alexisvl/mini-audioscope/datasheets/6LO1I-English.png

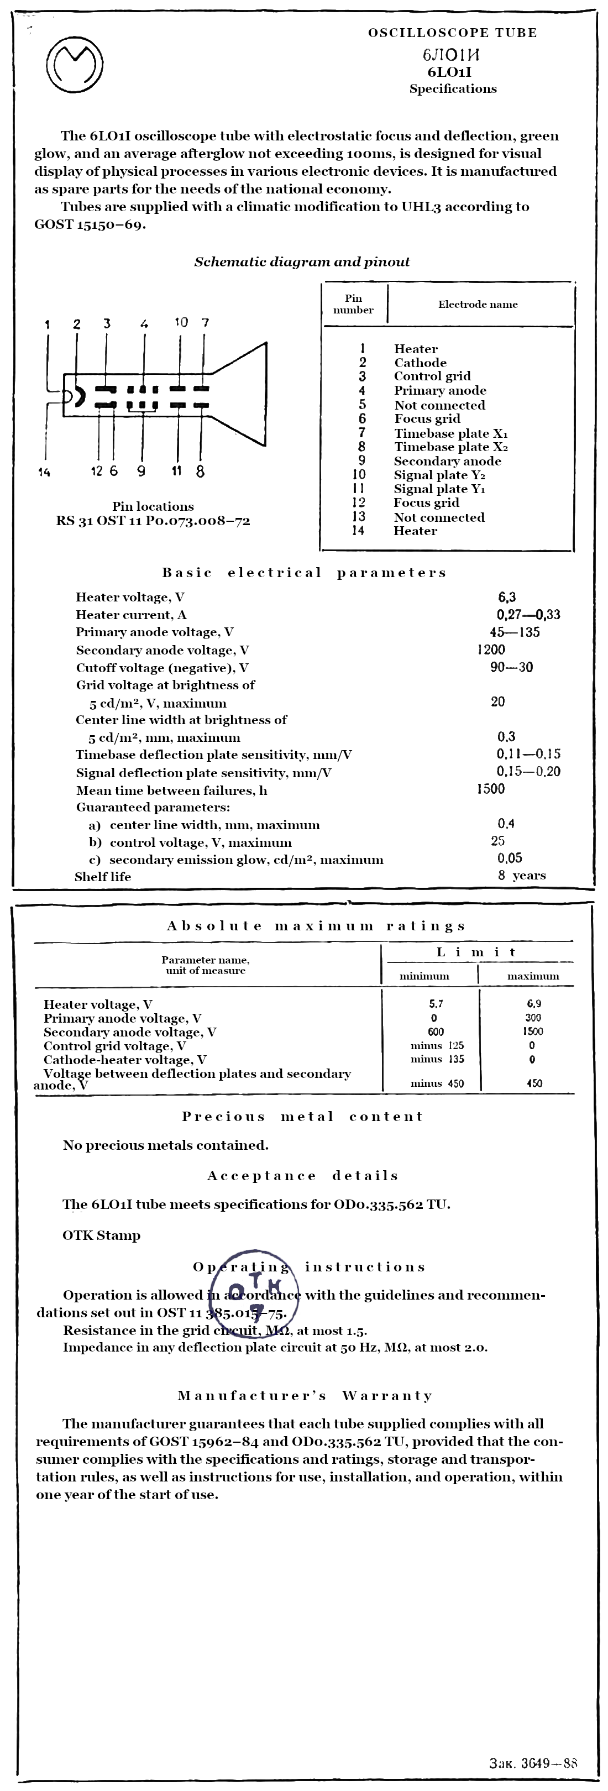
datasheets/6LO1I-English.png
