alexisvl/mini-audioscope/datasheets/6LO1I-Russian.png

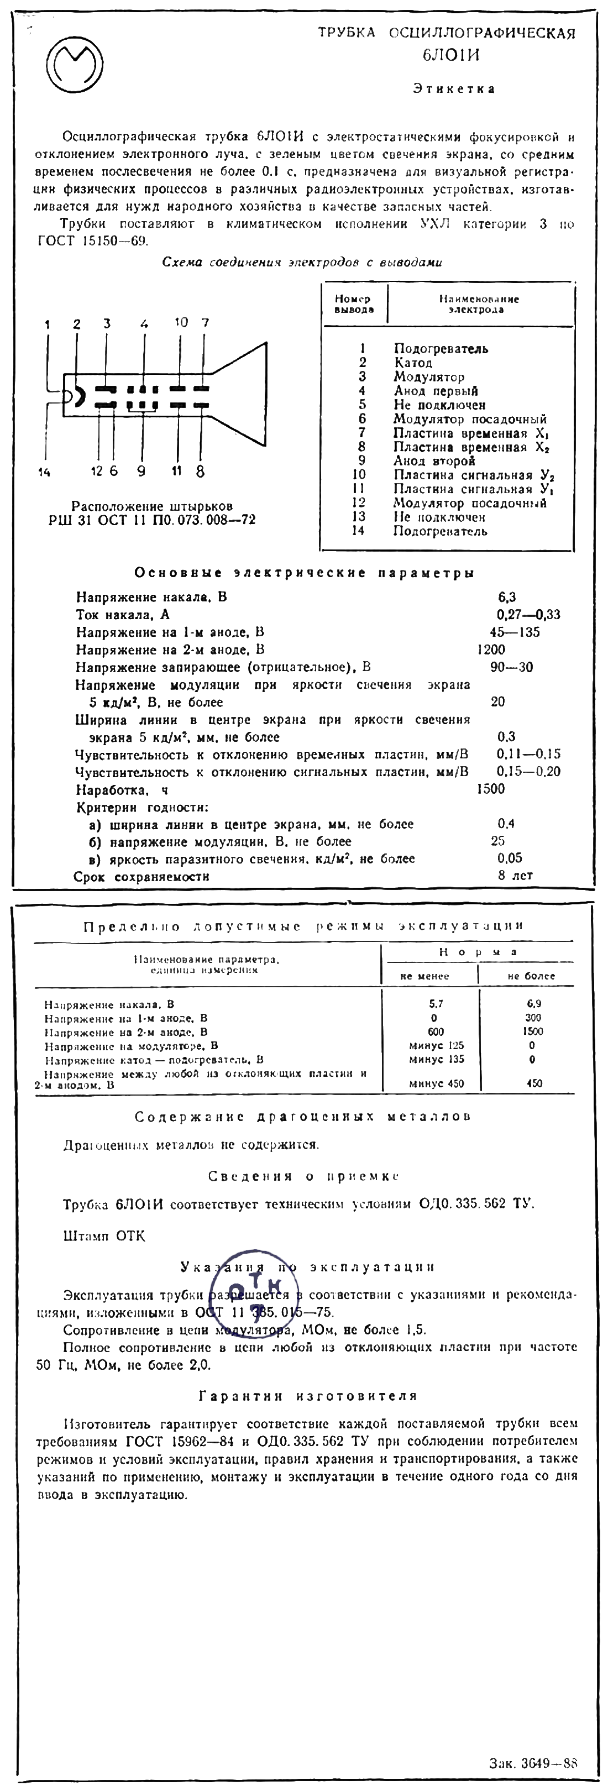
datasheets/6LO1I-Russian.png
