alexisvl/mini-audioscope/wiring-diagram.pdf

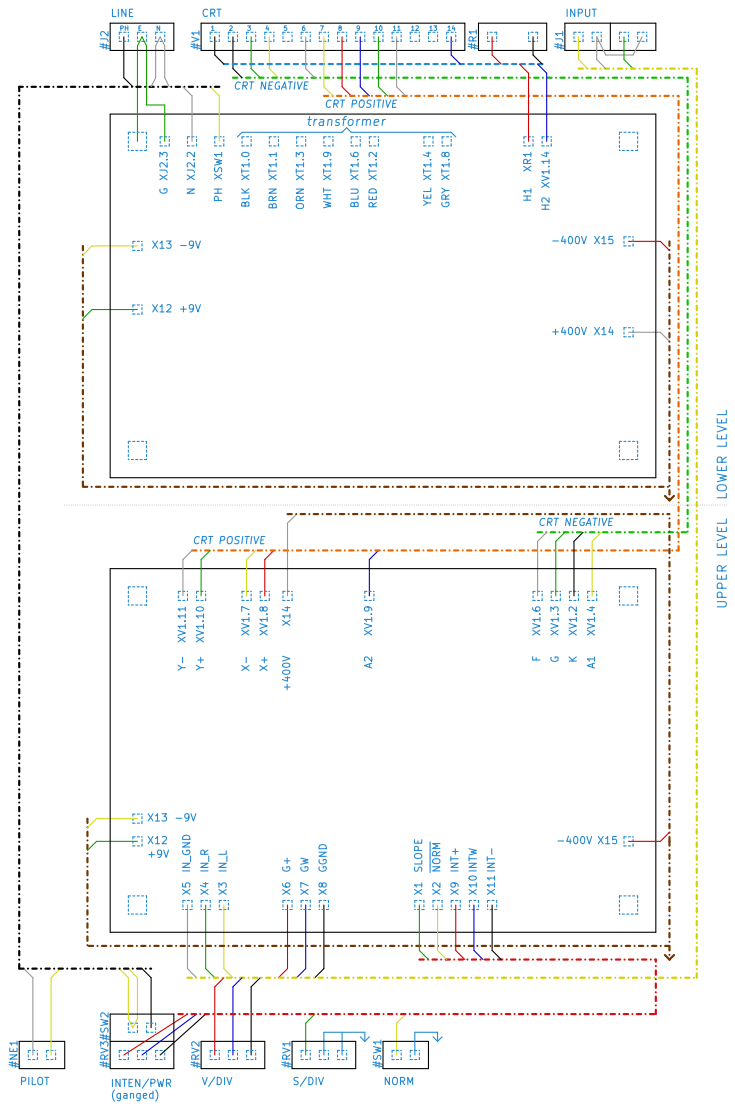
[picture p3: page 1]

File: wiring-diagram.sch Sheet: / Alexis Lockwood CC BY-SA-NC

Id: 1/1 Title: Mini Audioscope Wiring
