alexisvl/mini-audioscope/mini-audioscope.pdf

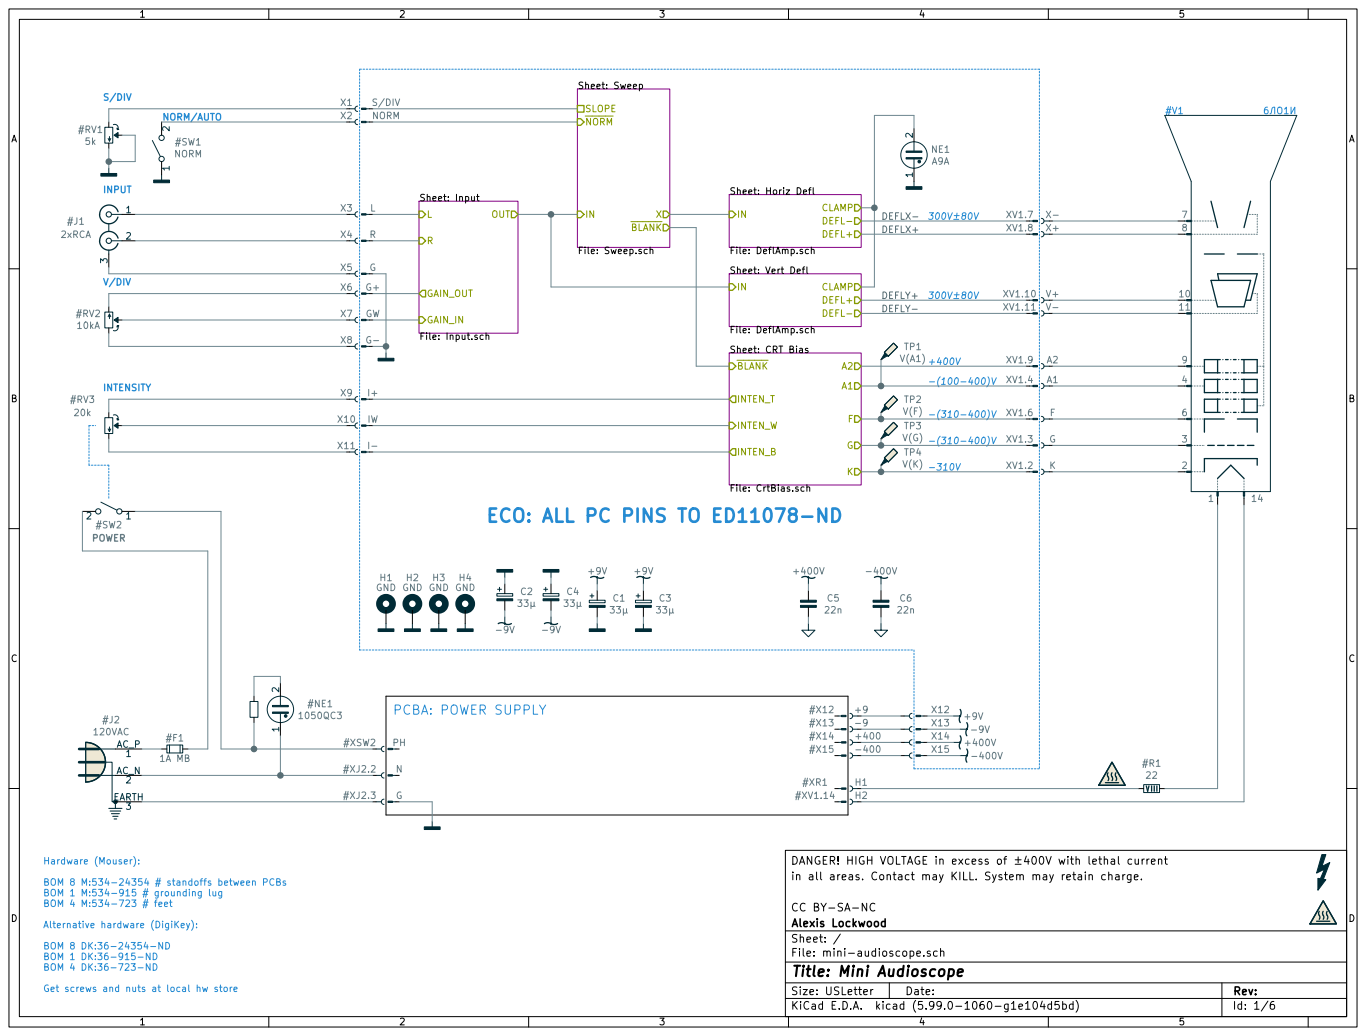
[picture p4: page 1]

BLANK
Sheet: CRT Bias File: CrtBias.sch BLANK

Hardware (Mouser): BOM 8 M:534-24354 # standoffs between PCBs BOM 1 M:534-915 # grounding lug BOM 4 M:534-723 # feet Alternative hardware (DigiKey): BOM 8 DK:36-24354-ND

in all areas. Contact may KILL. System may retain charge. DANGER! HIGH VOLTAGE in excess of ±400V with lethal current

File: mini-audioscope.sch Sheet: / Alexis Lockwood CC BY-SA-NC

Id: 1/6 Title: Mini Audioscope

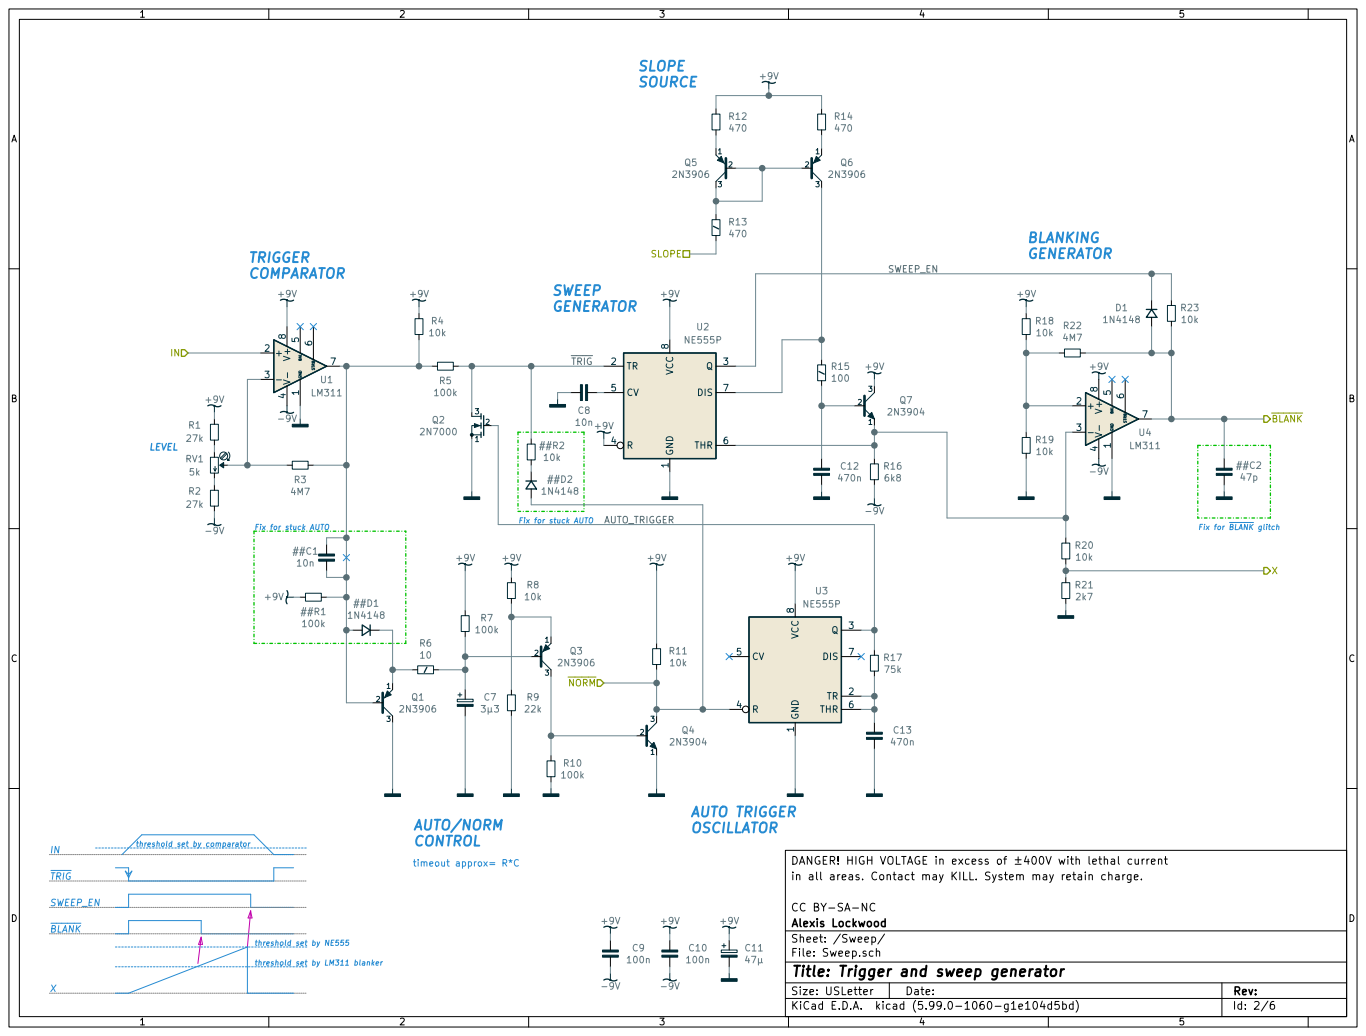
[picture p5: page 2]

Fix for BLANK glitch SWEEP
GENERATOR

in all areas. Contact may KILL. System may retain charge. DANGER! HIGH VOLTAGE in excess of ±400V with lethal current C8
BLANK NORM

Fix for stuck AUTO

threshold set by comparator IN

Sheet: /Sweep/ Alexis Lockwood CC BY-SA-NC

File: Sweep.sch
Id: 2/6 Title: Trigger and sweep generator

threshold set by LM311 blanker

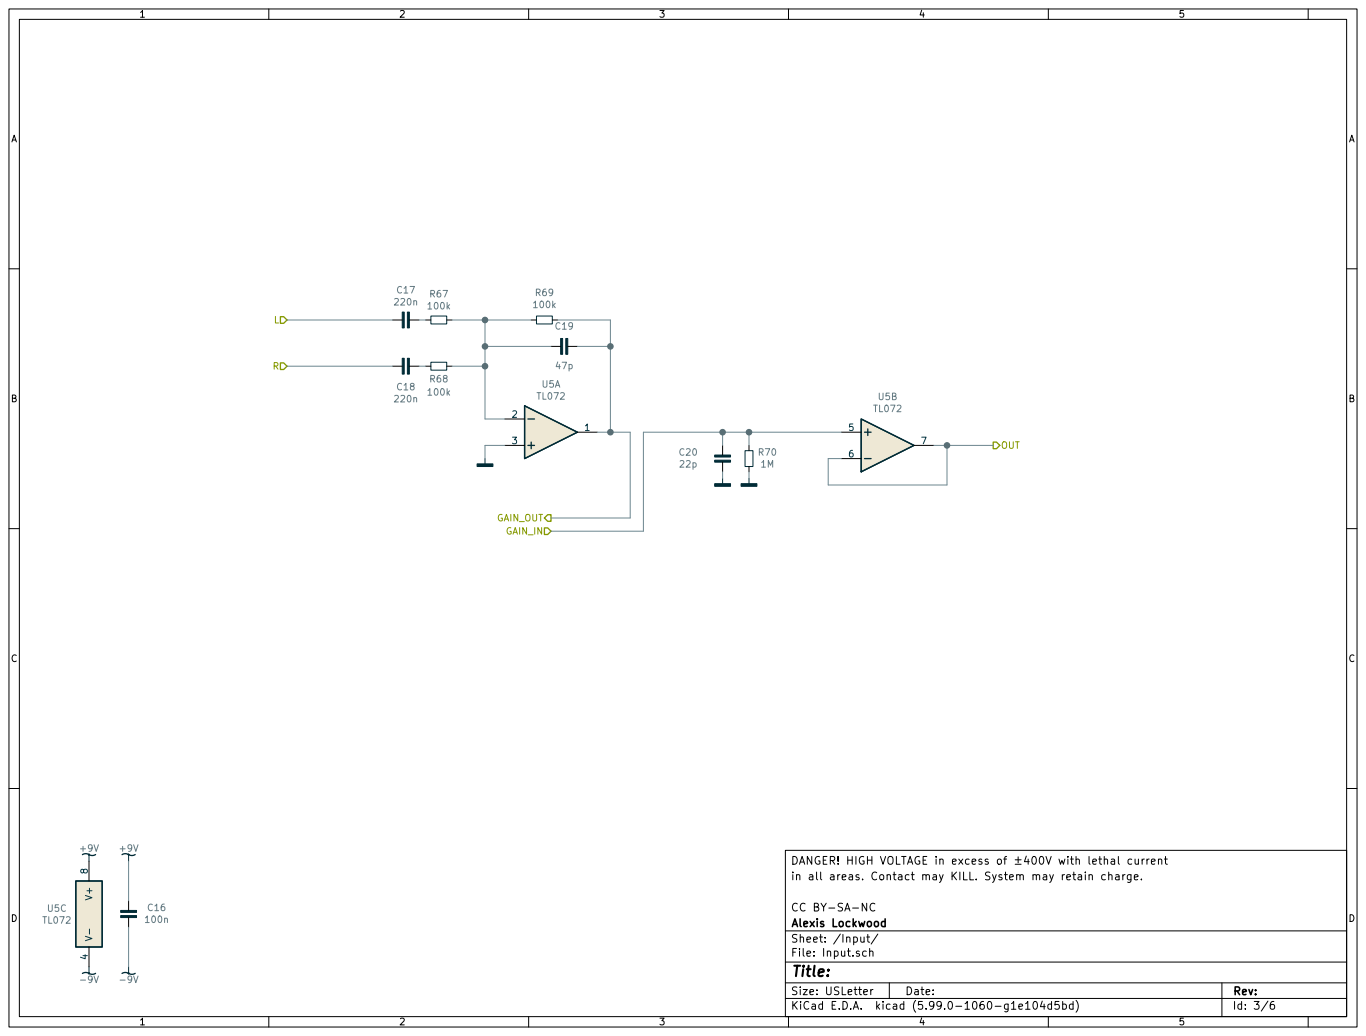
[picture p6: page 3]

in all areas. Contact may KILL. System may retain charge. DANGER! HIGH VOLTAGE in excess of ±400V with lethal current -9V

Sheet: /Input/ Alexis Lockwood CC BY-SA-NC

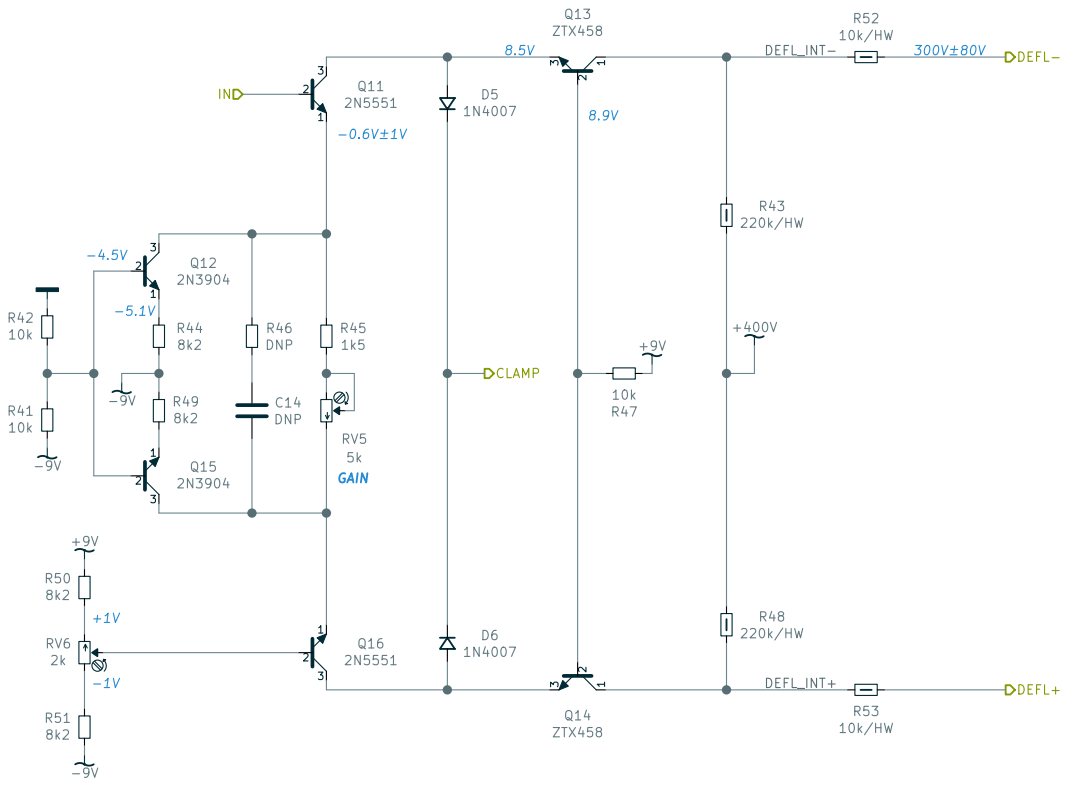
[picture p7: page 4]

in all areas. Contact may KILL. System may retain charge. DANGER! HIGH VOLTAGE in excess of ±400V with lethal current 1

File: DeflAmp.sch Sheet: /Horiz Defl/ Alexis Lockwood CC BY-SA-NC

Id: 4/6 Title: Deflection Amplifier

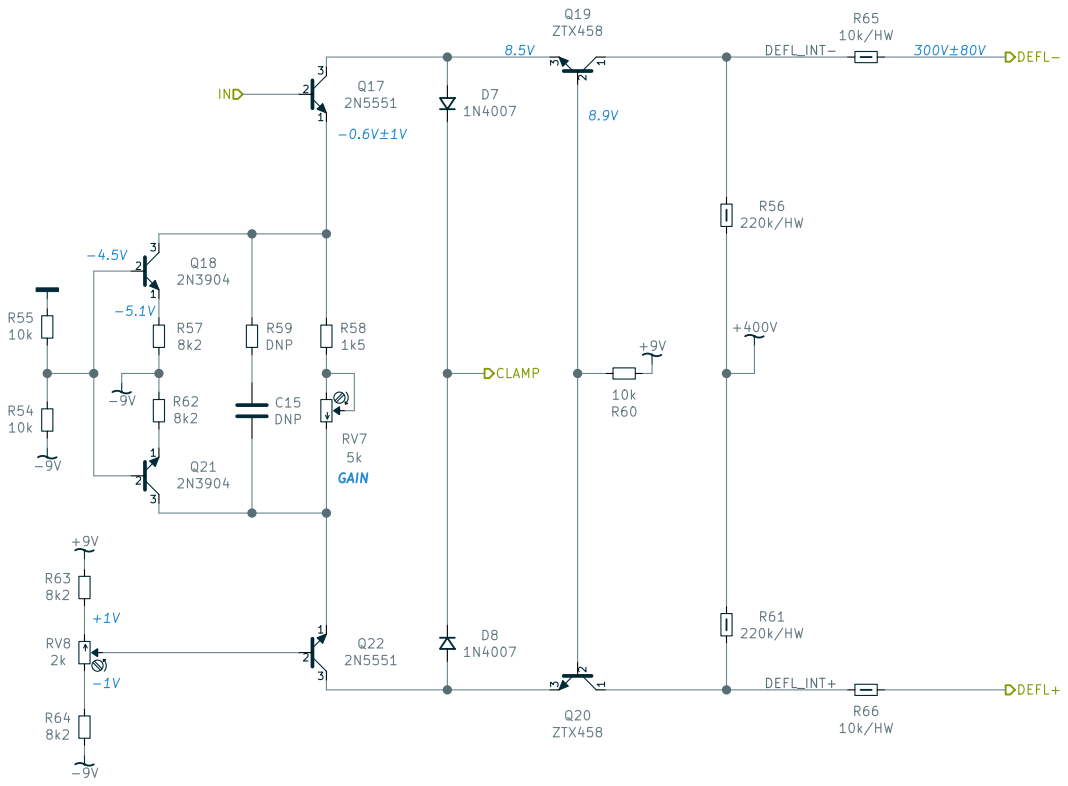
[picture p8: page 5]

in all areas. Contact may KILL. System may retain charge. DANGER! HIGH VOLTAGE in excess of ±400V with lethal current R63

File: DeflAmp.sch Sheet: /Vert Defl/ Alexis Lockwood CC BY-SA-NC

Id: 5/6 Title: Deflection Amplifier

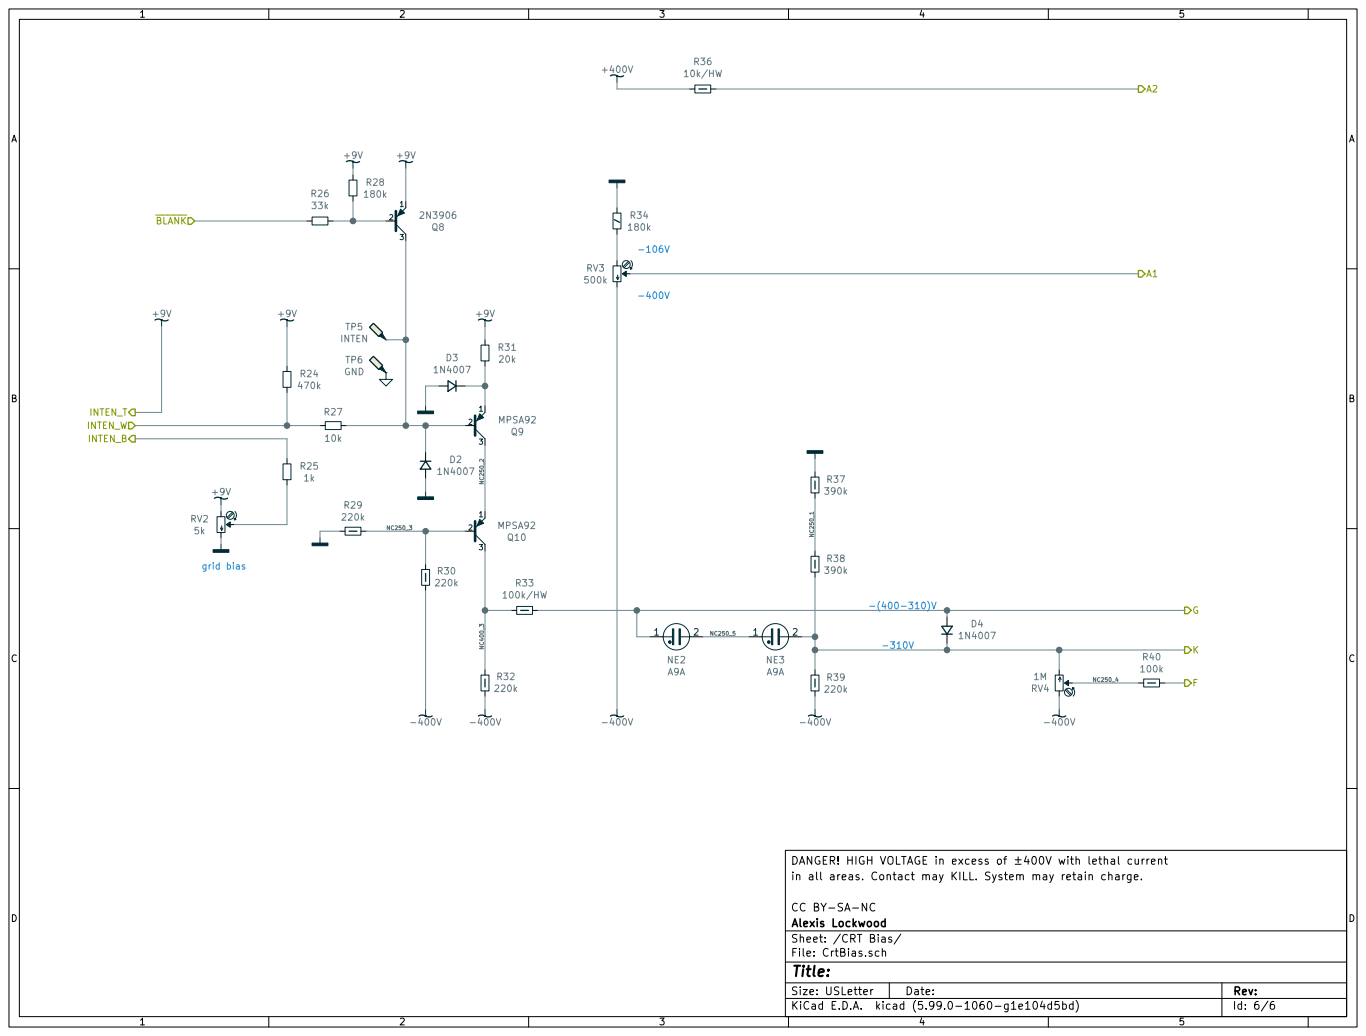
[picture p9: page 6]
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

Id: 6/6 Title: File: CrtBias.sch Sheet: /CRT Bias/ Alexis Lockwood CC BY-SA-NC
