alexisvl/mini-audioscope/pcb-power/pcb-power.pdf

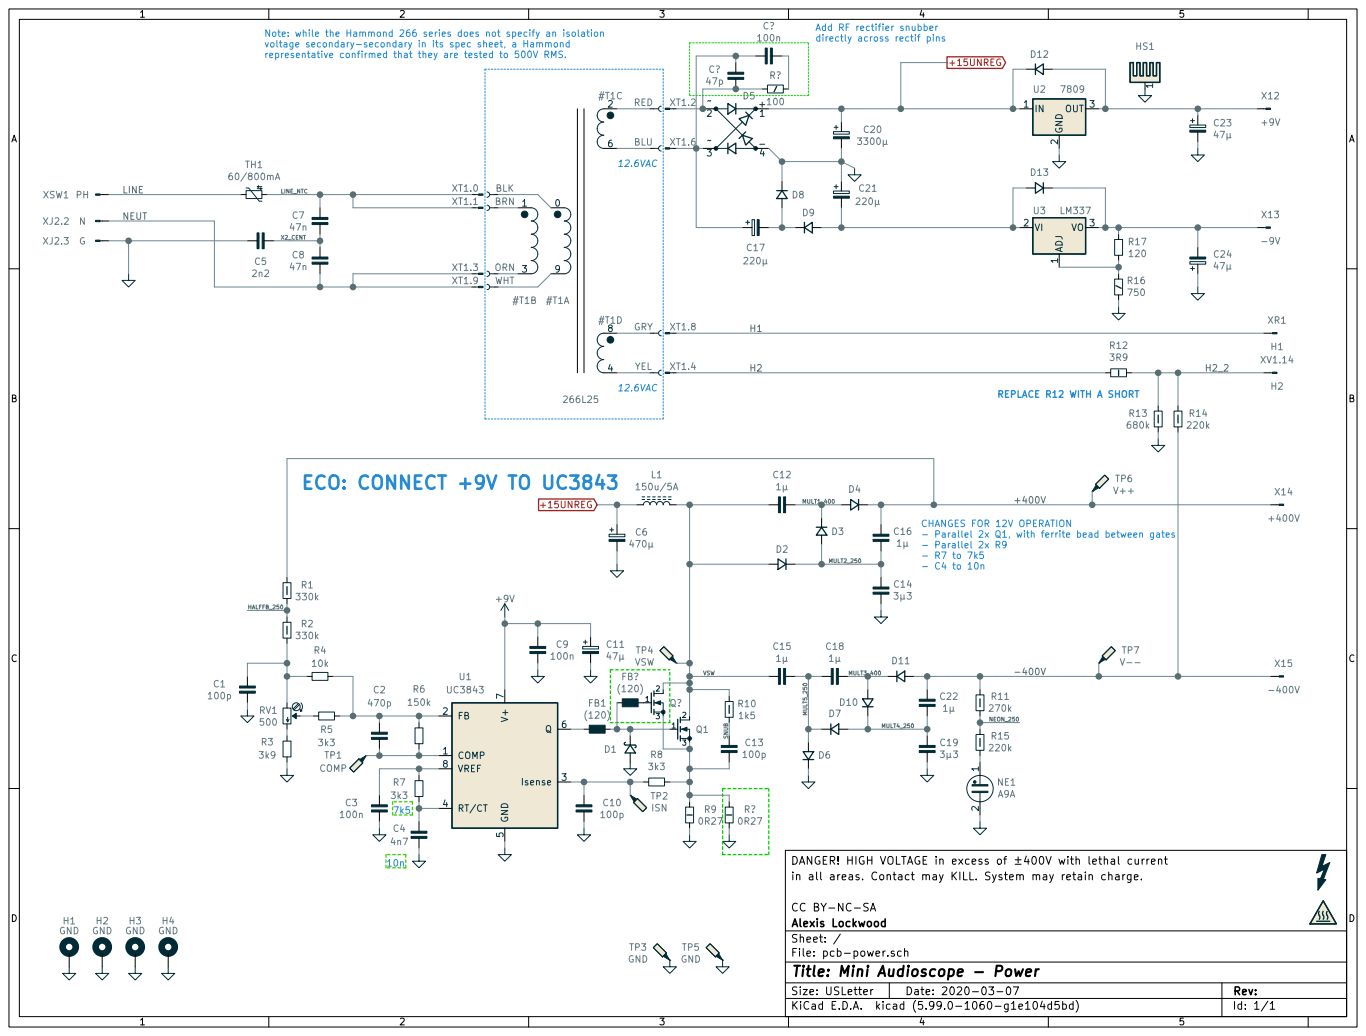
[picture p10: page 1]

Add RF rectifier snubber directly across rectif pins 12.6VAC

Note: while the Hammond 266 series does not specify an isolation
voltage secondary-secondary in its spec sheet, a Hammond

CHANGES FOR 12V OPERATION
- Parallel 2x Q1, with ferrite bead between gates
- Parallel 2x R9

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

File: pcb-power.sch Sheet: / Alexis Lockwood CC BY-NC-SA

Id: 1/1 Title: Mini Audioscope - Power
