alexisvl/mini-audioscope/spice/horiz.asc

C1: cap; 470n
C2: cap; 3µ3
C3: cap; 470n
C4: cap; 10n
C5: cap; 47p
D1: diode
D2: diode
D4: diode; 1N4148
M1: nmos; 2N7002
Q1: pnpr; 2N3906
Q2: npn; 2N3904
Q3: pnpr; 2N3906
Q4: pnpr; 2N3906
Q6: npn; 2N3904
R1: res; 6k8
R2: res; 3k3
R3: res; 1k
R4: res; 100k
R5: res; 10k
R6: res; 10k
R7: res; 4.7Meg
R8: res; 10k
R9: res; 20k
R10: res; 20k
R11: res; 4.7Meg
R12: res; 10k
R13: res; 10
R14: res; 100
R15: res; 75k
R16: res; 100k
R17: res; 10k
R18: res; 100k
R19: res; 100k
R20: res; 10k
R21: res; 2k7
R22: res; 100k
R23: res; 22k
R24: res; 10k
R25: res; 10k
U1: NE555
U2: LMx11
U4: NE555
U6: LMx11
V1: voltage; SINE(0 1 100 0.4 0 0 6.75)
V2: voltage; PULSE(0 1 467.06m)
V3: voltage; 9
V4: voltage; -9
Named nets: 0, V+, V-, sweep_en, x, _blank
.lib bipolar.lib
.tran 2 startup
