alexisvl/mini-audioscope/spice/power-uc3842.asc

C1: cap; 470p
C2: cap; 10n
C3: cap; 3µ3; Rser=0.15
C4: cap; 1µ; Rser=0.2
C5: cap; 1µ; Rser=0.2
C6: cap; 100p
C7: cap; 1µ; Rser=0.2
C8: cap; {5*22n}; Rser=0.2
C9: cap; 3µ3; Rser=0.15
C10: cap; 1µ; Rser=0.2
C11: cap; 100p
C12: cap; 100p
C13: cap; 100n
C15: cap; 470µ; Rser=.05
D2: diode; UF4007
D3: diode; UF4007
D4: diode; UF4007
D5: diode; UF4007
D6: diode; UF4007
D7: diode; UF4007
D8: diode; UF4007
D10: schottky; MBR0530L
L1: ind; 150µ; Rser=0.071
L2: FerriteBead; 377n; Ipk=3 Rser=0.027 Rpar=177 Cpar=847f mfg="Würth Elektronik" pn="742792023 WE-CBF 0805"
L3: FerriteBead; 377n; Ipk=3 Rser=0.027 Rpar=177 Cpar=847f mfg="Würth Elektronik" pn="742792023 WE-CBF 0805"
R2: res; 10k
R3: res; 1k5
R4: res; {0.27/2}
R5: res; 150k
R6: res; 7k5
R7: res; 330k
R8: res; 3k9
R9: res; 390k
R10: res; 3k3
R11: res; 80k
R12: res; 3k3
R13: res; 330k
U1: nmos-subckt; IPS70R1K4CE_L0
U2: neonbulb; Vstrike=90 Vhold=65
U3: pot; Rt=500 set=.5
U4: nmos-subckt; IPS70R1K4CE_L0
U5: LT1243
V1: voltage; 12; Rser=0.1
V2: voltage; 30; Rser=.01
V3: voltage; 9
Named nets: V+, +25, 0
.lib diode.lib
.tran 1 uic startup
.lib SimulationModel_PowerMOSFET_PSpice_700V_CoolMOS_CE.LIB
(IPN70R1K5CEATMA1)
