alexisvl/mini-audioscope/spice/deflection.asc

C1: cap; 47p
Q1: npn; MPSA44
Q2: npn; MPSA44
Q3: npn; 2N5551
Q4: npn; 2N5551
Q5: npn; 2N3904
Q6: npn; 2N3904
R1: res; 10k
R2: res; 470
R3: res; 470
R4: res; 1k5
R5: res; 5k
R6: res; 10k
R7: res; 10k
R8: res; 8k2
R9: res; 8k2
R10: res; 220k
R11: res; 220k
V1: voltage; 400
V2: voltage; 9
V3: voltage; -9
V4: voltage; SINE(0 1 10k); AC 1
Named nets: 0, +400, +9, -9
.lib bipolar.lib
.tran 10m
275 midpt
375 peak
;ac dec 50 10 500k
