alexisvl/mini-audioscope/spice/power.asc

C1: cap; 100p
C2: cap; 680p
C3: cap; 3µ3; Rser=2
C4: cap; 1µ; Rser=3
C5: cap; 1µ; Rser=3
C6: cap; 10n
C7: cap; 1µ; Rser=3
C8: cap; 1µ; Rser=3
C9: cap; 1µ; Rser=3
C10: cap; 1µ; Rser=3
C11: cap; 100p
D2: diode; UF4007
D3: diode; UF4007
D4: diode; UF4007
D5: diode; UF4007
D6: diode; UF4007
D7: diode; UF4007
D8: diode; UF4007
L1: ind; 150µ; Rser=0.01
M1: nmos; R6020PNJ
Q1: pnpr; 2N3906
Q2: npn; 2N3904
Q3: pnpr; 2N3906
Q4: npn; 2N3904
R1: res; 100
R2: res; 2.2
R3: res; 4k7
R4: res; 0.33
R5: res; 100
R6: res; 1k
R7: res; 470k
R8: res; 1k6
R9: res; 200k
R10: res; 4k7
R11: res; 330
U1: MC34063
U2: neonbulb
V1: voltage; 25; Rser=0.1
V2: voltage; 30; Rser=.01
V3: voltage; 15
Named nets: 0, V+, +25
.lib diode.lib
.tran 1 uic
