alexisvl/mini-audioscope/mini-audioscope.kicad_pcb

## KiCad design mini-audioscope.kicad_pcb (2020-03-29)

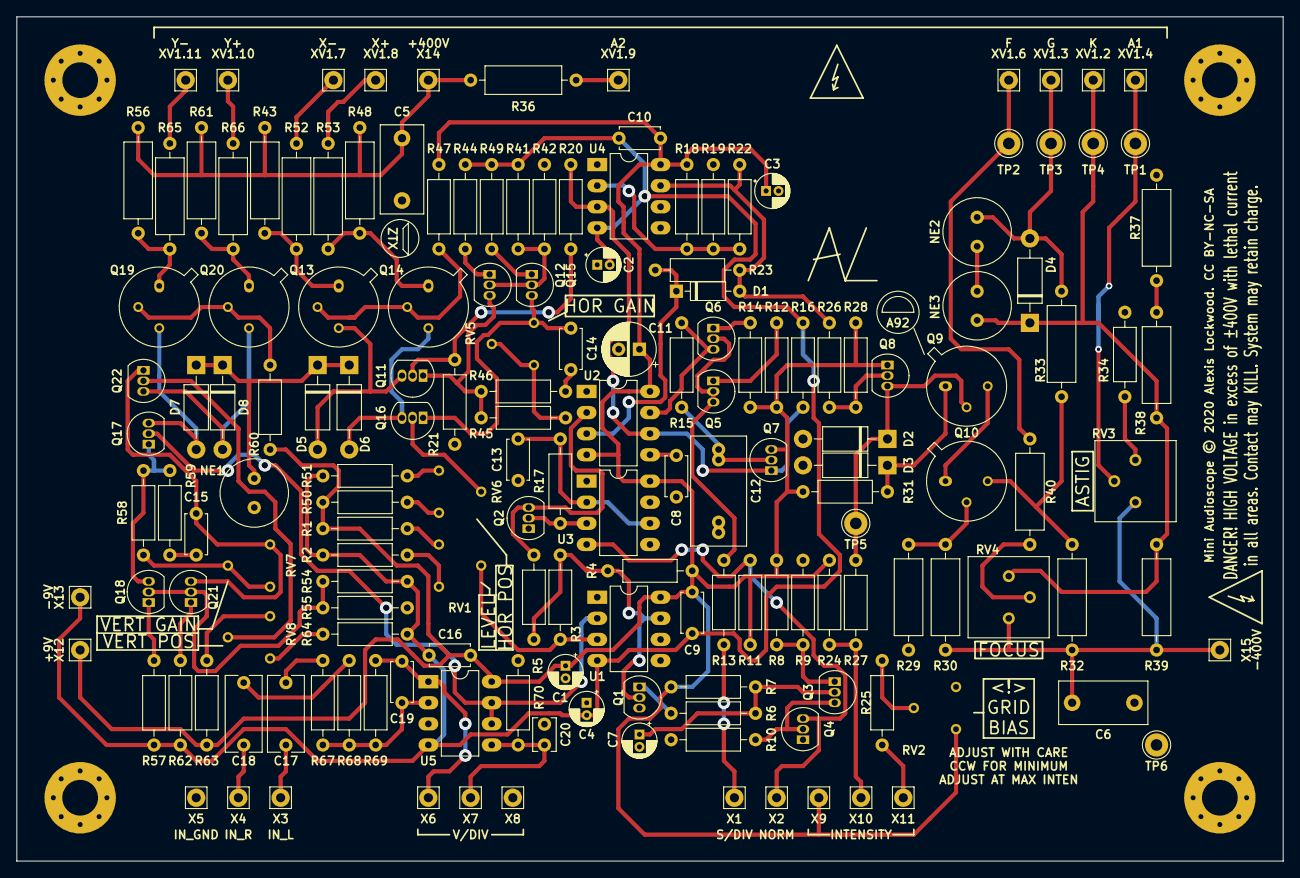
[picture p11: board mini-audioscope.kicad_pcb from above]

Board: 2 copper layers, 152.4 x 101.6 mm, 169 parts (0 on the bottom side), 90 nets.

Parts:
C1, C2, C3, C4: 33µ; CP_Radial_D4.0mm_P1.50mm
C5, C6: 22n; C_Disc_D10.5mm_W5.0mm_P7.50mm
C7: 3µ3; CP_Radial_D4.0mm_P1.50mm
C8: 10n; C_Disc_D4.7mm_W2.5mm_P5.00mm
C9, C10, C16: 100n; C_Disc_D4.7mm_W2.5mm_P5.00mm
C11: 47µ; CP_Radial_D6.3mm_P2.50mm
C12: 470n; C_Rect_L13.0mm_W6.5mm_P7.50mm_P10.00mm
C13: 470n; C_Disc_D4.7mm_W2.5mm_P5.00mm
C14, C15: DNP; C_Disc_D4.7mm_W2.5mm_P5.00mm
C17, C18: 220n; C_Rect_L9.0mm_W4.2mm_P7.50mm_MKT
C19: 47p; C_Disc_D4.7mm_W2.5mm_P5.00mm
C20: 22p; C_Disc_D3.8mm_W2.6mm_P2.50mm
D1: 1N4148; D_DO-35_SOD27_P7.62mm_Horizontal
D2, D3, D4, D5, D6, D7, D8: 1N4007; D_DO-41_SOD81_P10.16mm_Horizontal
H1, H2, H3, H4: GND; MountingHole_4.3mm_M4_Pad_Via
NE1, NE2, NE3: A9A; C_Radial_D8.0mm_H11.5mm_P3.50mm
Q1, Q3, Q5, Q6, Q8: 2N3906; TO-92_Inline
Q2: 2N7000; TO-92_Inline
Q4, Q7, Q12, Q15, Q18, Q21: 2N3904; TO-92_Inline
Q9, Q10: MPSA92; TO-5-3
Q11, Q16, Q17, Q22: 2N5551; TO-92_Inline
Q13, Q14, Q19, Q20: ZTX458; TO-5-3
R1, R2: 27k; R_Axial_DIN0207_L6.3mm_D2.5mm_P10.16mm_Horizontal
R3, R22: 4M7; R_Axial_DIN0207_L6.3mm_D2.5mm_P10.16mm_Horizontal
R4, R8, R11, R18, R19, R20, R23, R27, R41, R42, R47, R54, R55, R60: 10k; R_Axial_DIN0207_L6.3mm_D2.5mm_P10.16mm_Horizontal
R5, R7, R10, R67, R68, R69: 100k; R_Axial_DIN0207_L6.3mm_D2.5mm_P10.16mm_Horizontal
R6: 10; R_Axial_DIN0207_L6.3mm_D2.5mm_P10.16mm_Horizontal
R9: 22k; R_Axial_DIN0207_L6.3mm_D2.5mm_P10.16mm_Horizontal
R12, R13, R14: 470; R_Axial_DIN0207_L6.3mm_D2.5mm_P10.16mm_Horizontal
R15: 100; R_Axial_DIN0207_L6.3mm_D2.5mm_P10.16mm_Horizontal
R16: 6k8; R_Axial_DIN0207_L6.3mm_D2.5mm_P10.16mm_Horizontal
R17: 75k; R_Axial_DIN0207_L6.3mm_D2.5mm_P10.16mm_Horizontal
R21: 2k7; R_Axial_DIN0207_L6.3mm_D2.5mm_P10.16mm_Horizontal
R24: 470k; R_Axial_DIN0207_L6.3mm_D2.5mm_P10.16mm_Horizontal
R25: 1k; R_Axial_DIN0207_L6.3mm_D2.5mm_P10.16mm_Horizontal
R26: 33k; R_Axial_DIN0207_L6.3mm_D2.5mm_P10.16mm_Horizontal
R28, R34: 180k; R_Axial_DIN0207_L6.3mm_D2.5mm_P10.16mm_Horizontal
R29, R30, R32, R39, R43, R48, R56, R61: 220k/HW; R_Axial_DIN0309_L9.0mm_D3.2mm_P12.70mm_Horizontal
R31: 20k; R_Axial_DIN0207_L6.3mm_D2.5mm_P10.16mm_Horizontal
R33, R40: 100k/HW; R_Axial_DIN0309_L9.0mm_D3.2mm_P12.70mm_Horizontal
R36, R52, R53, R65, R66: 10k/HW; R_Axial_DIN0309_L9.0mm_D3.2mm_P12.70mm_Horizontal
R37, R38: 390k/HW; R_Axial_DIN0309_L9.0mm_D3.2mm_P12.70mm_Horizontal
R44, R49, R50, R51, R57, R62, R63, R64: 8k2; R_Axial_DIN0207_L6.3mm_D2.5mm_P10.16mm_Horizontal
R45, R58: 1k5; R_Axial_DIN0207_L6.3mm_D2.5mm_P10.16mm_Horizontal
R46, R59: DNP; R_Axial_DIN0207_L6.3mm_D2.5mm_P10.16mm_Horizontal
R70: 1M; R_Axial_DIN0207_L6.3mm_D2.5mm_P10.16mm_Horizontal
RV1, RV2, RV5, RV7: 5k; stock_pot
RV3: 500k; Potentiometer_Bourns_3386P_Vertical
RV4: 1M; Potentiometer_Bourns_3386P_Vertical
RV6, RV8: 2k; stock_pot
TP1: V(A1); TestPoint_Loop_D2.60mm_Drill1.4mm_Beaded
TP2: V(F); TestPoint_Loop_D2.60mm_Drill1.4mm_Beaded
TP3: V(G); TestPoint_Loop_D2.60mm_Drill1.4mm_Beaded
TP4: V(K); TestPoint_Loop_D2.60mm_Drill1.4mm_Beaded
TP5: INTEN; TestPoint_Loop_D2.60mm_Drill1.4mm_Beaded
TP6: GND; TestPoint_Loop_D2.60mm_Drill1.4mm_Beaded
U1, U4: LM311; DIP-8_W7.62mm_LongPads
U2, U3: NE555P; DIP-8_W7.62mm_LongPads
U5: TL072; DIP-8_W7.62mm_LongPads
X1: S/DIV; Pin_D1.1mm_L8.5mm_W2.5mm_FlatFork
X2: NORM; Pin_D1.1mm_L8.5mm_W2.5mm_FlatFork
X3: L; Pin_D1.1mm_L8.5mm_W2.5mm_FlatFork
X4: R; Pin_D1.1mm_L8.5mm_W2.5mm_FlatFork
X5: G; Pin_D1.1mm_L8.5mm_W2.5mm_FlatFork
X6: G+; Pin_D1.1mm_L8.5mm_W2.5mm_FlatFork
X7: GW; Pin_D1.1mm_L8.5mm_W2.5mm_FlatFork
X8: G-; Pin_D1.1mm_L8.5mm_W2.5mm_FlatFork
X9: I+; Pin_D1.1mm_L8.5mm_W2.5mm_FlatFork
X10: IW; Pin_D1.1mm_L8.5mm_W2.5mm_FlatFork
X11: I-; Pin_D1.1mm_L8.5mm_W2.5mm_FlatFork
X12: +9; Pin_D1.1mm_L8.5mm_W2.5mm_FlatFork
X13: -9; Pin_D1.1mm_L8.5mm_W2.5mm_FlatFork
X14: +400; Pin_D1.1mm_L8.5mm_W2.5mm_FlatFork
X15: -400; Pin_D1.1mm_L8.5mm_W2.5mm_FlatFork
XV1.2: K; Pin_D1.1mm_L8.5mm_W2.5mm_FlatFork
XV1.3: G; Pin_D1.1mm_L8.5mm_W2.5mm_FlatFork
XV1.4: A1; Pin_D1.1mm_L8.5mm_W2.5mm_FlatFork
XV1.6: F; Pin_D1.1mm_L8.5mm_W2.5mm_FlatFork
XV1.7: X-; Pin_D1.1mm_L8.5mm_W2.5mm_FlatFork
XV1.8: X+; Pin_D1.1mm_L8.5mm_W2.5mm_FlatFork
XV1.9: A2; Pin_D1.1mm_L8.5mm_W2.5mm_FlatFork
XV1.10: V+; Pin_D1.1mm_L8.5mm_W2.5mm_FlatFork
XV1.11: V-; Pin_D1.1mm_L8.5mm_W2.5mm_FlatFork

Connections:
+9V: C1.1, C3.1, C9.1, C10.1, C11.1, C16.2, Q7.3, Q8.1, R1.2, R4.1, R7.1, R8.1, R11.1, R12.1, R14.1, R18.1, R24.1, R28.1, R31.1, R47.1, R50.2, R60.1, R63.2, RV2.1, U1.8, U2.4, U2.8, U3.8, U4.8, U5.8, X9.1, X12.1
+400V: C5.1, R36.1, R43.1, R48.1, R56.1, R61.1, X14.1
-9V: C2.2, C4.2, C9.2, C10.2, C16.1, R2.1, R16.2, R41.1, R44.2, R49.2, R51.1, R54.1, R57.2, R62.2, R64.1, U1.4, U4.4, U5.4, X13.1
-400V: C6.1, R30.1, R32.1, R39.2, RV3.3, RV4.1, X15.1
/A1: RV3.2, TP1.1, XV1.4.1
/A2: R36.2, XV1.9.1
/CLAMP: D5.1, D6.1, D7.1, D8.1, NE1.2
/CRT Bias/NC250_1: R37.2, R38.1
/CRT Bias/NC250_2: Q9.3, Q10.1
/CRT Bias/NC250_3: Q10.2, R29.2, R30.2
/CRT Bias/NC250_4: R40.1, RV4.2
/CRT Bias/NC250_5: NE2.2, NE3.1
/CRT Bias/NC400_3: Q10.3, R32.2, R33.1
/DEFLX+: R53.2, XV1.8.1
/DEFLX-: R52.2, XV1.7.1
/DEFLY+: R66.2, XV1.10.1
/DEFLY-: R65.2, XV1.11.1
/F: R40.2, TP2.1, XV1.6.1
/G: D4.2, NE2.1, R33.2, TP3.1, XV1.3.1
/GAIN_IN: C20.2, R70.2, U5.5, X7.1
/GAIN_OUT: C19.2, R69.2, U5.1, X6.1
/Horiz Defl/DEFL_INT+: Q14.1, R48.2, R53.1
/Horiz Defl/DEFL_INT-: Q13.1, R43.2, R52.1
/INTEN_B: R25.1, X11.1
/INTEN_W: R24.2, R27.1, X10.1
/K: D4.1, NE3.2, R38.2, R39.1, RV4.3, TP4.1, XV1.2.1
/L: C17.1, X3.1
/OUT: Q17.2, U1.2, U5.6, U5.7
/R: C18.1, X4.1
/SLOPE: R13.2, X1.1
/Sweep/AUTO_TRIGGER: Q2.2, R17.1, U3.3
/Sweep/SWEEP_EN: D1.1, R23.1, U2.3
/Sweep/~TRIG: Q2.3, R5.2, U2.2
/Vert Defl/DEFL_INT+: Q20.1, R61.2, R66.1
/Vert Defl/DEFL_INT-: Q19.1, R56.2, R65.1
/X: Q11.2, R20.2, R21.1
/~BLANK: D1.2, R22.2, R23.2, R26.1, U4.7
/~NORM: Q4.3, R11.2, U3.4, X2.1
GND: C1.2, C2.1, C3.2, C4.1, C5.2, C6.2, C7.2, C8.1, C11.2, C12.2, C13.2, C20.1, D2.2, D3.2, H1.1, H2.1, H3.1, H4.1, NE1.1, Q1.3, Q2.1, Q4.1, R9.2, R10.2, R19.2, R21.2, R29.1, R34.1, R37.1, R42.2, R55.2, R70.1, RV2.3, TP6.1, U1.1, U2.1, U3.1, U4.1, U5.3, X5.1, X8.1
unnamed: C7.1, Q3.2, R6.1, R7.2
unnamed: C8.2, U2.5
unnamed: C12.1, Q7.2, R15.1
unnamed: C13.1, R17.2, U3.2, U3.6
unnamed: C14.1, R46.2
unnamed: C14.2, Q15.3, Q16.1, RV5.3
unnamed: C15.1, R59.2
unnamed: C15.2, Q21.3, Q22.1, RV7.3
unnamed: C17.2, R67.1
unnamed: C18.2, R68.1
unnamed: C19.1, R67.2, R68.2, R69.1, U5.2
unnamed: D2.1, Q8.3, Q9.2, R27.2, TP5.1
unnamed: D3.1, Q9.1, R31.2
unnamed: D5.2, Q11.3, Q13.3
unnamed: D6.2, Q14.3, Q16.3
unnamed: D7.2, Q17.3, Q19.3
unnamed: D8.2, Q20.3, Q22.3
unnamed: Q1.1, R6.2
unnamed: Q1.2, R3.2, R4.2, R5.1, U1.7
unnamed: Q3.1, R8.2, R9.1
unnamed: Q3.3, Q4.2, R10.1
unnamed: Q5.1, R12.2
unnamed: Q5.2, Q5.3, Q6.2, R13.1
unnamed: Q6.1, R14.2
unnamed: Q6.3, R15.2, U2.7
unnamed: Q7.1, R16.1, R20.1, U2.6, U4.3
unnamed: Q8.2, R26.2, R28.2
unnamed: Q11.1, Q12.3, R45.1, R46.1
unnamed: Q12.1, R44.1
unnamed: Q12.2, Q15.2, R41.2, R42.1
unnamed: Q13.2, Q14.2, R47.2
unnamed: Q15.1, R49.1
unnamed: Q16.2, RV6.2
unnamed: Q17.1, Q18.3, R58.1, R59.1
unnamed: Q18.1, R57.1
unnamed: Q18.2, Q21.2, R54.2, R55.1
unnamed: Q19.2, Q20.2, R60.2
unnamed: Q21.1, R62.1
unnamed: Q22.2, RV8.2
unnamed: R1.1, RV1.1
unnamed: R2.2, RV1.3
unnamed: R3.1, RV1.2, U1.3
unnamed: R18.2, R19.1, R22.1, U4.2
unnamed: R25.2, RV2.2
unnamed: R34.2, RV3.1
unnamed: R45.2, RV5.1, RV5.2
unnamed: R50.1, RV6.3
unnamed: R51.2, RV6.1
unnamed: R58.2, RV7.1, RV7.2
unnamed: R63.1, RV8.3
unnamed: R64.2, RV8.1
