alexisvl/mini-audioscope/pcb-power/pcb-power.kicad_pcb

## KiCad design pcb-power/pcb-power.kicad_pcb (2020-03-20)

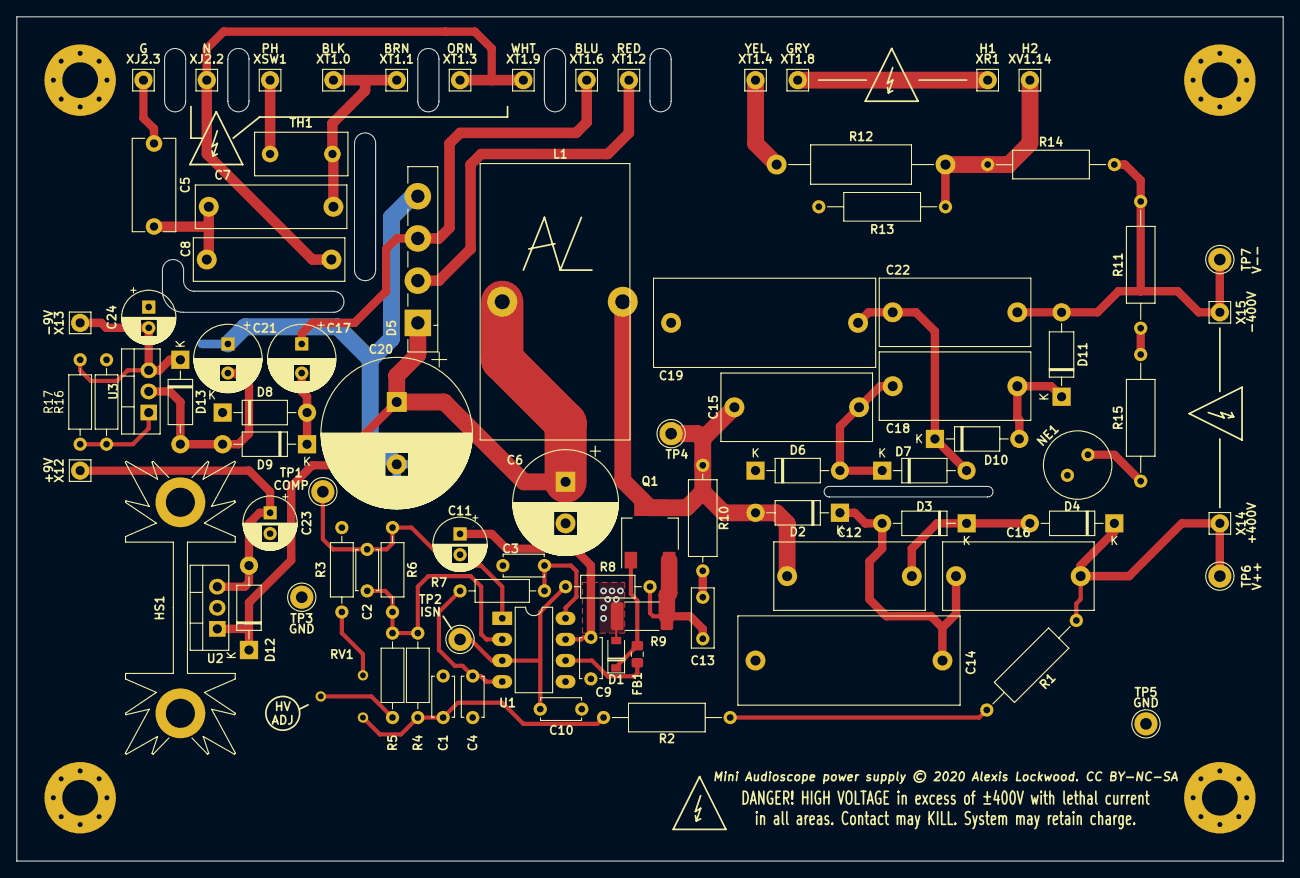
[picture p12: board pcb-power.kicad_pcb from above]

Board: 2 copper layers, 152.4 x 101.6 mm, 92 parts (0 on the bottom side), 40 nets.

Parts:
C1, C10: 100p; C_Disc_D4.7mm_W2.5mm_P5.00mm
C2: 470p; C_Disc_D4.7mm_W2.5mm_P5.00mm
C3, C9: 100n; C_Disc_D4.7mm_W2.5mm_P5.00mm
C4: 4n7; C_Disc_D4.7mm_W2.5mm_P5.00mm
C5: 2n2/Y2; C_Disc_D11.0mm_W5.0mm_P10.00mm
C6: 470u; CP_Radial_D12.5mm_P5.00mm
C7, C8: 47n/X2; C_Rect_L18.0mm_W5.0mm_P15.00mm_FKS3_FKP3
C11, C23, C24: 47u; CP_Radial_D6.3mm_P2.50mm
C12, C15, C16, C18, C22: 1u/450; C_Rect_L18.0mm_W8.0mm_P15.00mm_FKS3_FKP3
C13: 100p/500V; C_Disc_D7.0mm_W2.5mm_P5.00mm
C14, C19: 3u3/450; C_Rect_L26.5mm_W10.5mm_P22.50mm_MKS4
C17, C21: 220u; CP_Radial_D8.0mm_P3.50mm
C20: 3300u; CP_Radial_D18.0mm_P7.50mm
D1: MBR0540; D_SOD-123
D2, D3, D4, D6, D7, D10, D11: UF4007; D_DO-41_SOD81_P10.16mm_Horizontal
D5: GBU4J; Diode_Bridge_Vishay_GBU
D8, D9: 1N4007; D_DO-41_SOD81_P10.16mm_Horizontal
D12, D13: 1N4004; D_DO-41_SOD81_P10.16mm_Horizontal
FB1: 742792023; L_0805_2012Metric_Pad1.15x1.40mm_HandSolder
H1, H2, H3, H4: GND; MountingHole_4.3mm_M4_Pad_Via
HS1: 513102B02500G; Heatsink_Fischer_SK104-STCB_35x13mm__2xDrill3.5mm_ScrewM3
L1: 150u/5A; L_Toroid_Vertical_L33.0mm_W17.8mm_P12.70mm_Pulse_KM-5
NE1: A9A; C_Radial_D8.0mm_H11.5mm_P3.50mm
Q1: IPN70R1K5CE; SOT-223-3_TabPin2
R1, R2: 330k/½W; R_Axial_DIN0309_L9.0mm_D3.2mm_P15.24mm_Horizontal
R3: 3k9; R_Axial_DIN0207_L6.3mm_D2.5mm_P10.16mm_Horizontal
R4: 10k; R_Axial_DIN0207_L6.3mm_D2.5mm_P10.16mm_Horizontal
R5, R7: 3k3; R_Axial_DIN0207_L6.3mm_D2.5mm_P10.16mm_Horizontal
R6: 150k; R_Axial_DIN0207_L6.3mm_D2.5mm_P10.16mm_Horizontal
R8: 1k; R_Axial_DIN0207_L6.3mm_D2.5mm_P10.16mm_Horizontal
R9: 0R27/1W; R_2512_6332Metric_Pad1.52x3.35mm_HandSolder
R10: 1k5/½W; R_Axial_DIN0309_L9.0mm_D3.2mm_P12.70mm_Horizontal
R11: 270k/HW; R_Axial_DIN0309_L9.0mm_D3.2mm_P15.24mm_Horizontal
R12: 3R9/1W; R_Axial_DIN0414_L11.9mm_D4.5mm_P20.32mm_Horizontal
R13: 680k/HW; R_Axial_DIN0309_L9.0mm_D3.2mm_P15.24mm_Horizontal
R14, R15: 220k/HW; R_Axial_DIN0309_L9.0mm_D3.2mm_P15.24mm_Horizontal
R16: 750; R_Axial_DIN0207_L6.3mm_D2.5mm_P10.16mm_Horizontal
R17: 120; R_Axial_DIN0207_L6.3mm_D2.5mm_P10.16mm_Horizontal
RV1: 500; stock_pot
TH1: 60/800mA; C_Disc_D11.0mm_W5.0mm_P7.50mm
TP1: COMP; TestPoint_Loop_D2.60mm_Drill1.4mm_Beaded
TP2: ISN; TestPoint_Loop_D2.60mm_Drill1.4mm_Beaded
TP3, TP5: GND; TestPoint_Loop_D2.60mm_Drill1.4mm_Beaded
TP4: VSW; TestPoint_Loop_D2.60mm_Drill1.4mm_Beaded
TP6: V++; TestPoint_Loop_D2.60mm_Drill1.4mm_Beaded
TP7: V--; TestPoint_Loop_D2.60mm_Drill1.4mm_Beaded
U1: UC3843; DIP-8_W7.62mm_LongPads
U2: 7809; TO-220-3_Vertical
U3: LM337; TO-220-3_Vertical
X12: +9V; Pin_D1.1mm_L8.5mm_W2.5mm_FlatFork
X13: -9V; Pin_D1.1mm_L8.5mm_W2.5mm_FlatFork
X14: +400V; Pin_D1.1mm_L8.5mm_W2.5mm_FlatFork
X15: -400V; Pin_D1.1mm_L8.5mm_W2.5mm_FlatFork
XJ2.2: N; Pin_D1.1mm_L8.5mm_W2.5mm_FlatFork
XJ2.3: G; Pin_D1.1mm_L8.5mm_W2.5mm_FlatFork
XR1: H1; Pin_D1.1mm_L8.5mm_W2.5mm_FlatFork
XSW1: PH; Pin_D1.1mm_L8.5mm_W2.5mm_FlatFork
XT1.0: BLK; Pin_D1.1mm_L8.5mm_W2.5mm_FlatFork
XT1.1: BRN; Pin_D1.1mm_L8.5mm_W2.5mm_FlatFork
XT1.2: RED; Pin_D1.1mm_L8.5mm_W2.5mm_FlatFork
XT1.3: ORN; Pin_D1.1mm_L8.5mm_W2.5mm_FlatFork
XT1.4: YEL; Pin_D1.1mm_L8.5mm_W2.5mm_FlatFork
XT1.6: BLU; Pin_D1.1mm_L8.5mm_W2.5mm_FlatFork
XT1.8: GRY; Pin_D1.1mm_L8.5mm_W2.5mm_FlatFork
XT1.9: WHT; Pin_D1.1mm_L8.5mm_W2.5mm_FlatFork
XV1.14: H2; Pin_D1.1mm_L8.5mm_W2.5mm_FlatFork

Connections:
+9V: C9.1, C11.1, U1.7
+15UNREG: C6.1, C20.1, D5.1, D12.1, L1.1, U2.1
/+400V: C16.2, D4.1, R1.1, TP6.1, X14.1
/-400V: C22.2, D11.2, R11.2, R14.2, TP7.1, X15.1
/H1: XR1.1, XT1.8.1
/H2: R12.1, XT1.4.1
/H2_2: R12.2, R13.1, R14.1, XV1.14.1
/HALFFB_250: R1.2, R2.2
/LINE: TH1.1, XSW1.1
/LINE_NTC: C7.1, TH1.2, XT1.0.1, XT1.1.1
/MULT1_400: C12.2, D3.1, D4.2
/MULT2_250: C14.2, C16.1, D2.1, D3.2
/MULT3_400: C18.2, D10.2, D11.1
/MULT4_250: C19.2, C22.1, D7.2, D10.1
/MULT5_250: C15.2, C18.1, D6.2, D7.1
/NEON_250: R11.1, R15.2
/NEUT: C8.2, XJ2.2.1, XT1.3.1, XT1.9.1
/SNUB: C13.2, R10.2
/VSW: C12.1, C15.1, D2.2, L1.2, Q1.2, R10.1, TP4.1
/X2_CENT: C5.2, C7.2, C8.1
GND: C1.2, C3.2, C4.2, C5.1, C6.2, C9.2, C10.2, C11.2, C14.1, C19.1, C20.2, C21.1, C23.2, C24.1, D1.2, D5.4, D6.1, D8.1, H1.1, H2.1, H3.1, H4.1, HS1.1, NE1.2, R3.1, R9.2, R13.2, R16.1, TP3.1, TP5.1, U1.5, U2.2, XJ2.3.1
unnamed: C1.1, R2.1, R4.2, RV1.1
unnamed: C2.1, R4.1, R5.1, R6.2, U1.2
unnamed: C2.2, R6.1, TP1.1, U1.1
unnamed: C3.1, R7.1, U1.8
unnamed: C4.1, R7.2, U1.4
unnamed: C10.1, R8.1, TP2.1, U1.3
unnamed: C13.1, Q1.3, R8.2, R9.1
unnamed: C17.1, D5.3, XT1.6.1
unnamed: C17.2, D8.2, D9.1
unnamed: C21.2, D9.2, D13.2, U3.2
unnamed: C23.1, D12.2, U2.3, X12.1
unnamed: C24.2, D13.1, R17.1, U3.3, X13.1
unnamed: D1.1, FB1.2, Q1.1
unnamed: D5.2, XT1.2.1
unnamed: FB1.1, U1.6
unnamed: NE1.1, R15.1
unnamed: R3.2, RV1.3
unnamed: R5.2, RV1.2
unnamed: R16.2, R17.2, U3.1
