alexisvl/mini-audioscope/(commit log)

2020-03-04 Commit what I have...
    [CathodeBias.sch, CrtBias.sch, DeflAmp.sch, HVPS.sch, LV_Line.sch, Sweep.sch, mini-audioscope.kicad_pcb, mini-audioscope.sch]
2020-03-05 Power supply changes
    [CrtBias.sch, DeflAmp.sch, HVPS.sch, LV_Line.sch, Sweep.sch, mini-audioscope.sch]
2020-03-05 Better auto sweep timeout circuit
    [Sweep.sch]
2020-03-05 Bring back the norm switch
    [Sweep.sch]
2020-03-08 Commit before re-routing
    [CrtBias.sch, DeflAmp.sch, HVPS.sch, Input.sch, LV_Line.sch, Sweep.sch, mini-audioscope.kicad_pcb, mini-audioscope.sch]
2020-03-08 Before second re-route
    [CrtBias.sch, DeflAmp.sch, Input.sch, Sweep.sch, mini-audioscope.kicad_pcb, mini-audioscope.sch, pcb-power.kicad_pcb, pcb-power.sch]
2020-03-11 Cleaned up
    [CrtBias.sch, DeflAmp.sch, Input.sch, Sweep.sch, mini-audioscope.kicad_pcb, mini-audioscope.sch, pcb-power.kicad_pcb, pcb-power.sch]
2020-03-20 Version sent to fab
    [CathodeBias.sch, CrtBias.sch, DeflAmp.sch, HVPS.sch, Input.sch, LV_Line.sch, Sweep.sch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]
2020-03-29 Schematic updates
    [CrtBias.sch, DeflAmp.sch, Input.sch, Sweep.sch, mini-audioscope.kicad_pcb, mini-audioscope.sch, pcb-power.sch, wiring-diagram.sch]
