alexisvl/mini-audioscope/(notices)

Notices in the files:
pcb-power/pcb-power.kicad_pcb:
Mini Audioscope power supply © 2020 Alexis Lockwood. CC BY-NC-SA
mini-audioscope.kicad_pcb:
Mini Audioscope © 2020 Alexis Lockwood. CC BY-NC-SA
